ramb0t/Apollo-Voltmeter/README.md

Apollo-Voltmeter
================

Voltmeter Code for Design Two Module
