ramb0t/Apollo-Voltmeter/Eagle Project/Apollo Voltmeter/Main Board Rev1.0.bmp

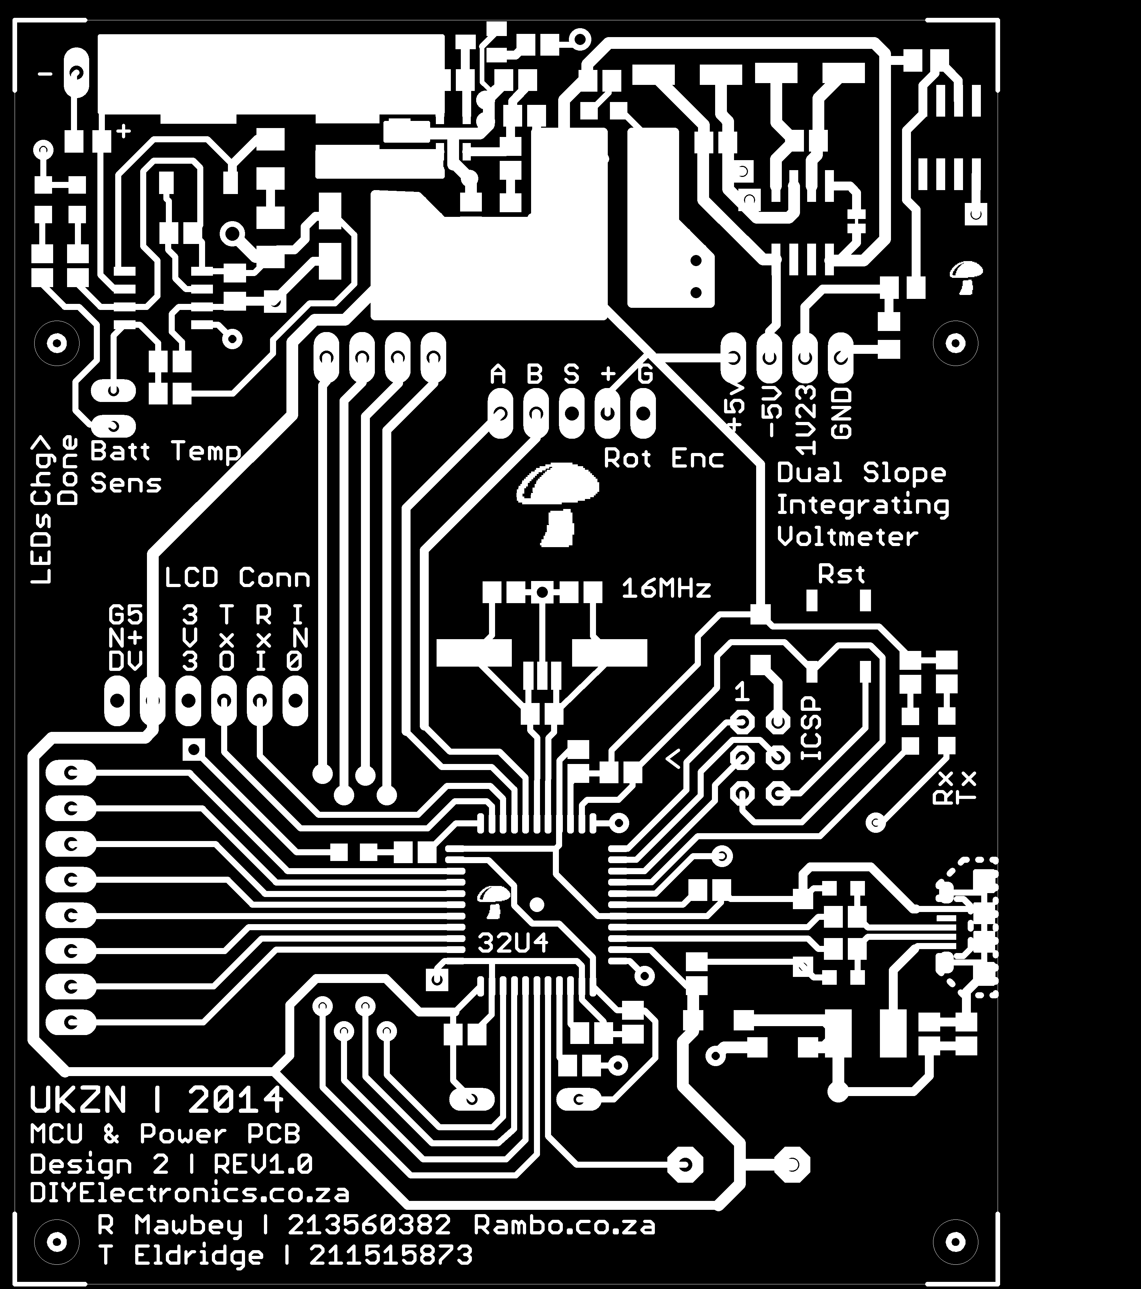
Eagle Project/Apollo Voltmeter/Main Board Rev1.0.bmp
