ramb0t/Apollo-Voltmeter/Eagle Project/Apollo Voltmeter/Panel Rev1.0.pdf

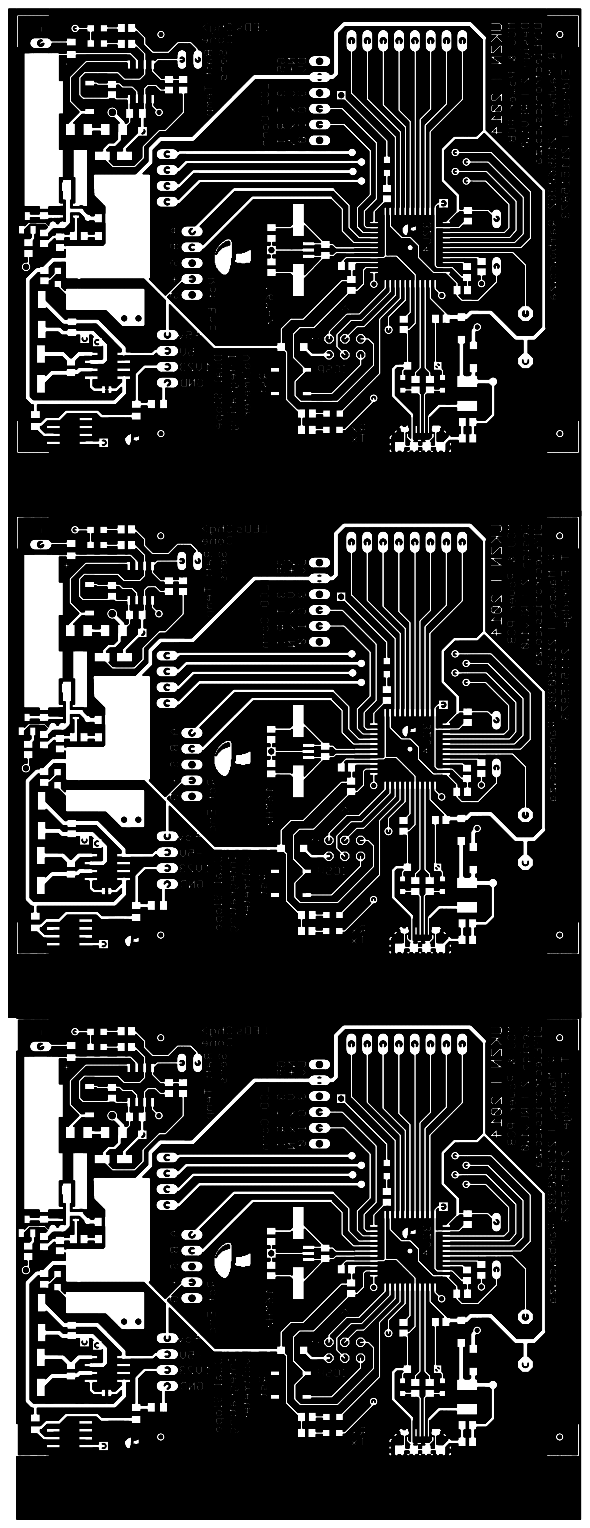
[picture p2: page 1]
