ramb0t/Apollo-Voltmeter/Eagle Project/Apollo Voltmeter/Vboost.brd

## EAGLE design Eagle Project/Apollo Voltmeter/Vboost.brd (2015-03-23)

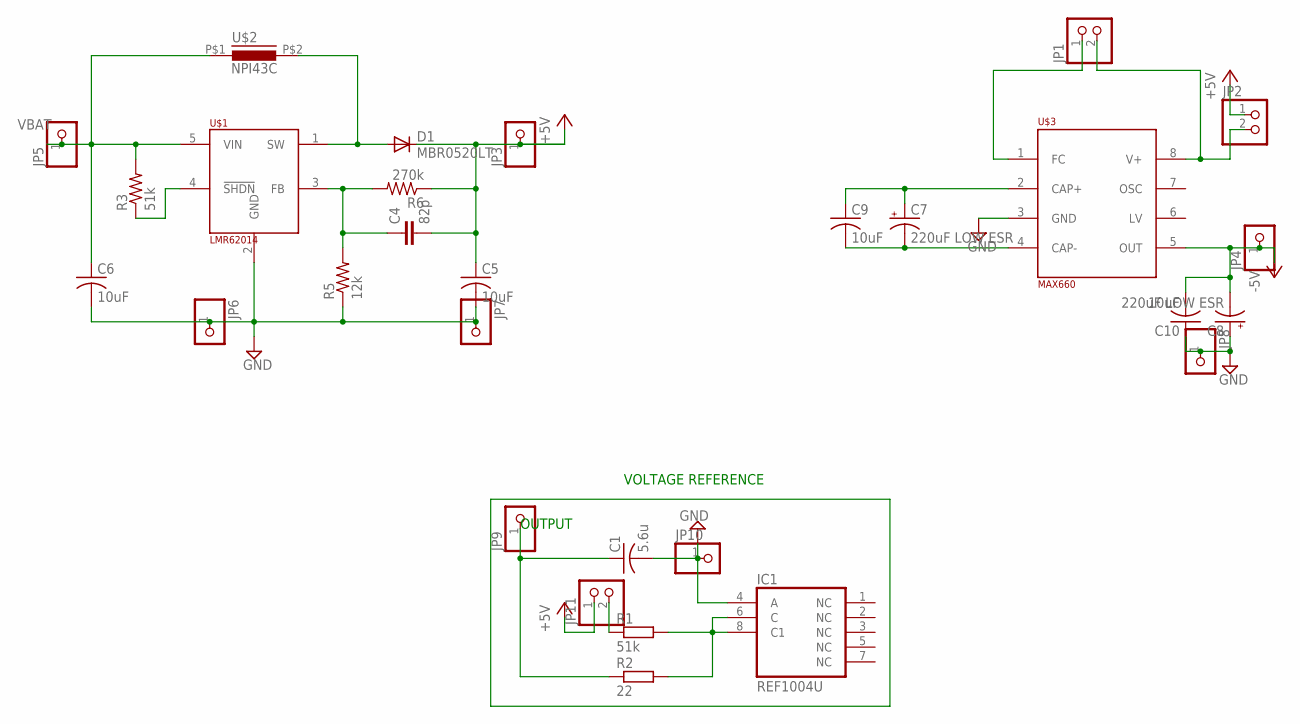
[picture p3: schematic Vboost.sch]

Parts:
C1: 5.6u; C0805K
C4: 82p; C0805
C5, C6, C9, C10: 10uF; C0805
C7, C8: 220uF LOW ESR; PANASONIC_D
D1: MBR0520LT; SOD123
IC1: REF1004U; SO08
JP1, JP2, JP11: PINHD-1X2; 1X02
JP3, JP4, JP5, JP6, JP7, JP8, JP9, JP10: PINHD-1X1; 1X01
R1: 51k; M0805
R2: 22; M0805
R3: 51k; R0805
R5: 12k; R0805
R6: 270k; R0805
U$1: LMR62014; SOT23-5
U$2: NPI43C
U$3: MAX660; SO08

Connections:
+5V: C4.2, C5.1, D1.C, JP2.1, JP3.1, JP11.1, R6.1
-5V: C8.-, C10.2, JP4.1, U$3.5 (OUT)
GND: C1.2, C5.2, C6.2, C8.+, C10.1, IC1.4 (A), JP6.1, JP7.1, JP8.1, JP10.1, R5.1, U$1.2 (GND), U$3.3 (GND)
unnamed: JP1.2, JP2.2, U$3.8 (V+)
unnamed: IC1.6 (C), IC1.8 (C1), R1.2, R2.2
unnamed: C1.1, JP9.1, R2.1
unnamed: C7.+, C9.1, U$3.2 (CAP+)
unnamed: JP11.2, R1.1
unnamed: R3.1, U$1.4 (!SHDN)
unnamed: C7.-, C9.2, U$3.4 (CAP-)
unnamed: C4.1, R5.2, R6.2, U$1.3 (FB)
unnamed: JP1.1, U$3.1 (FC)
SW: D1.A, U$1.1 (SW), U$2.P$2 (2)
VBAT: C6.1, JP5.1, R3.2, U$1.5 (VIN), U$2.P$1 (1)

Notes on the sheet:
OUTPUT
VOLTAGE REFERENCE

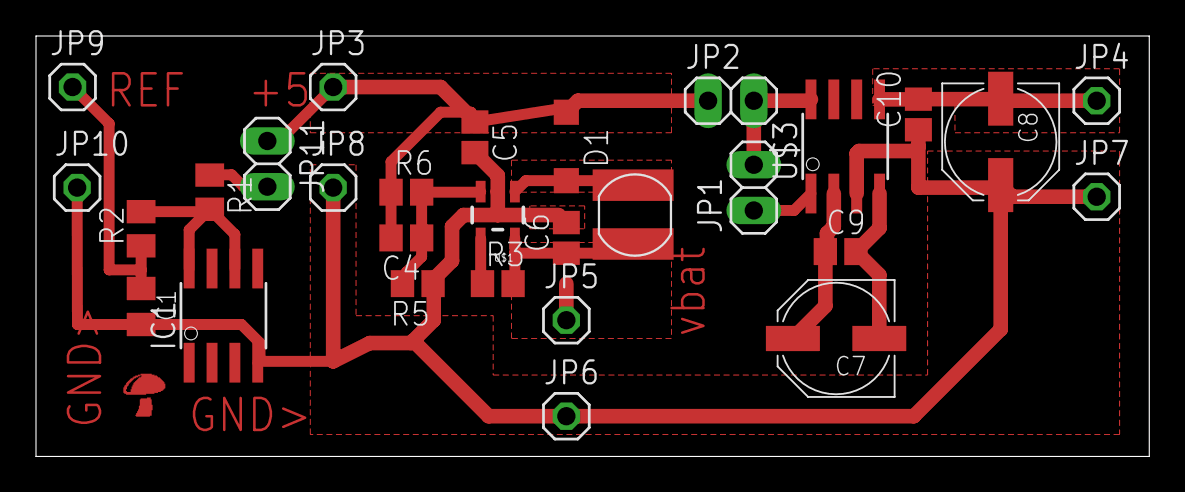
[picture p4: board Vboost.brd from above]

Board: 2 copper layers, 61.8 x 23.4 mm, 29 parts (0 on the bottom side), 14 nets.
