ramb0t/Apollo-Voltmeter/Eagle Project/Apollo Voltmeter/MCU Design exp.brd

## EAGLE design Eagle Project/Apollo Voltmeter/MCU Design exp.brd (2015-03-23)

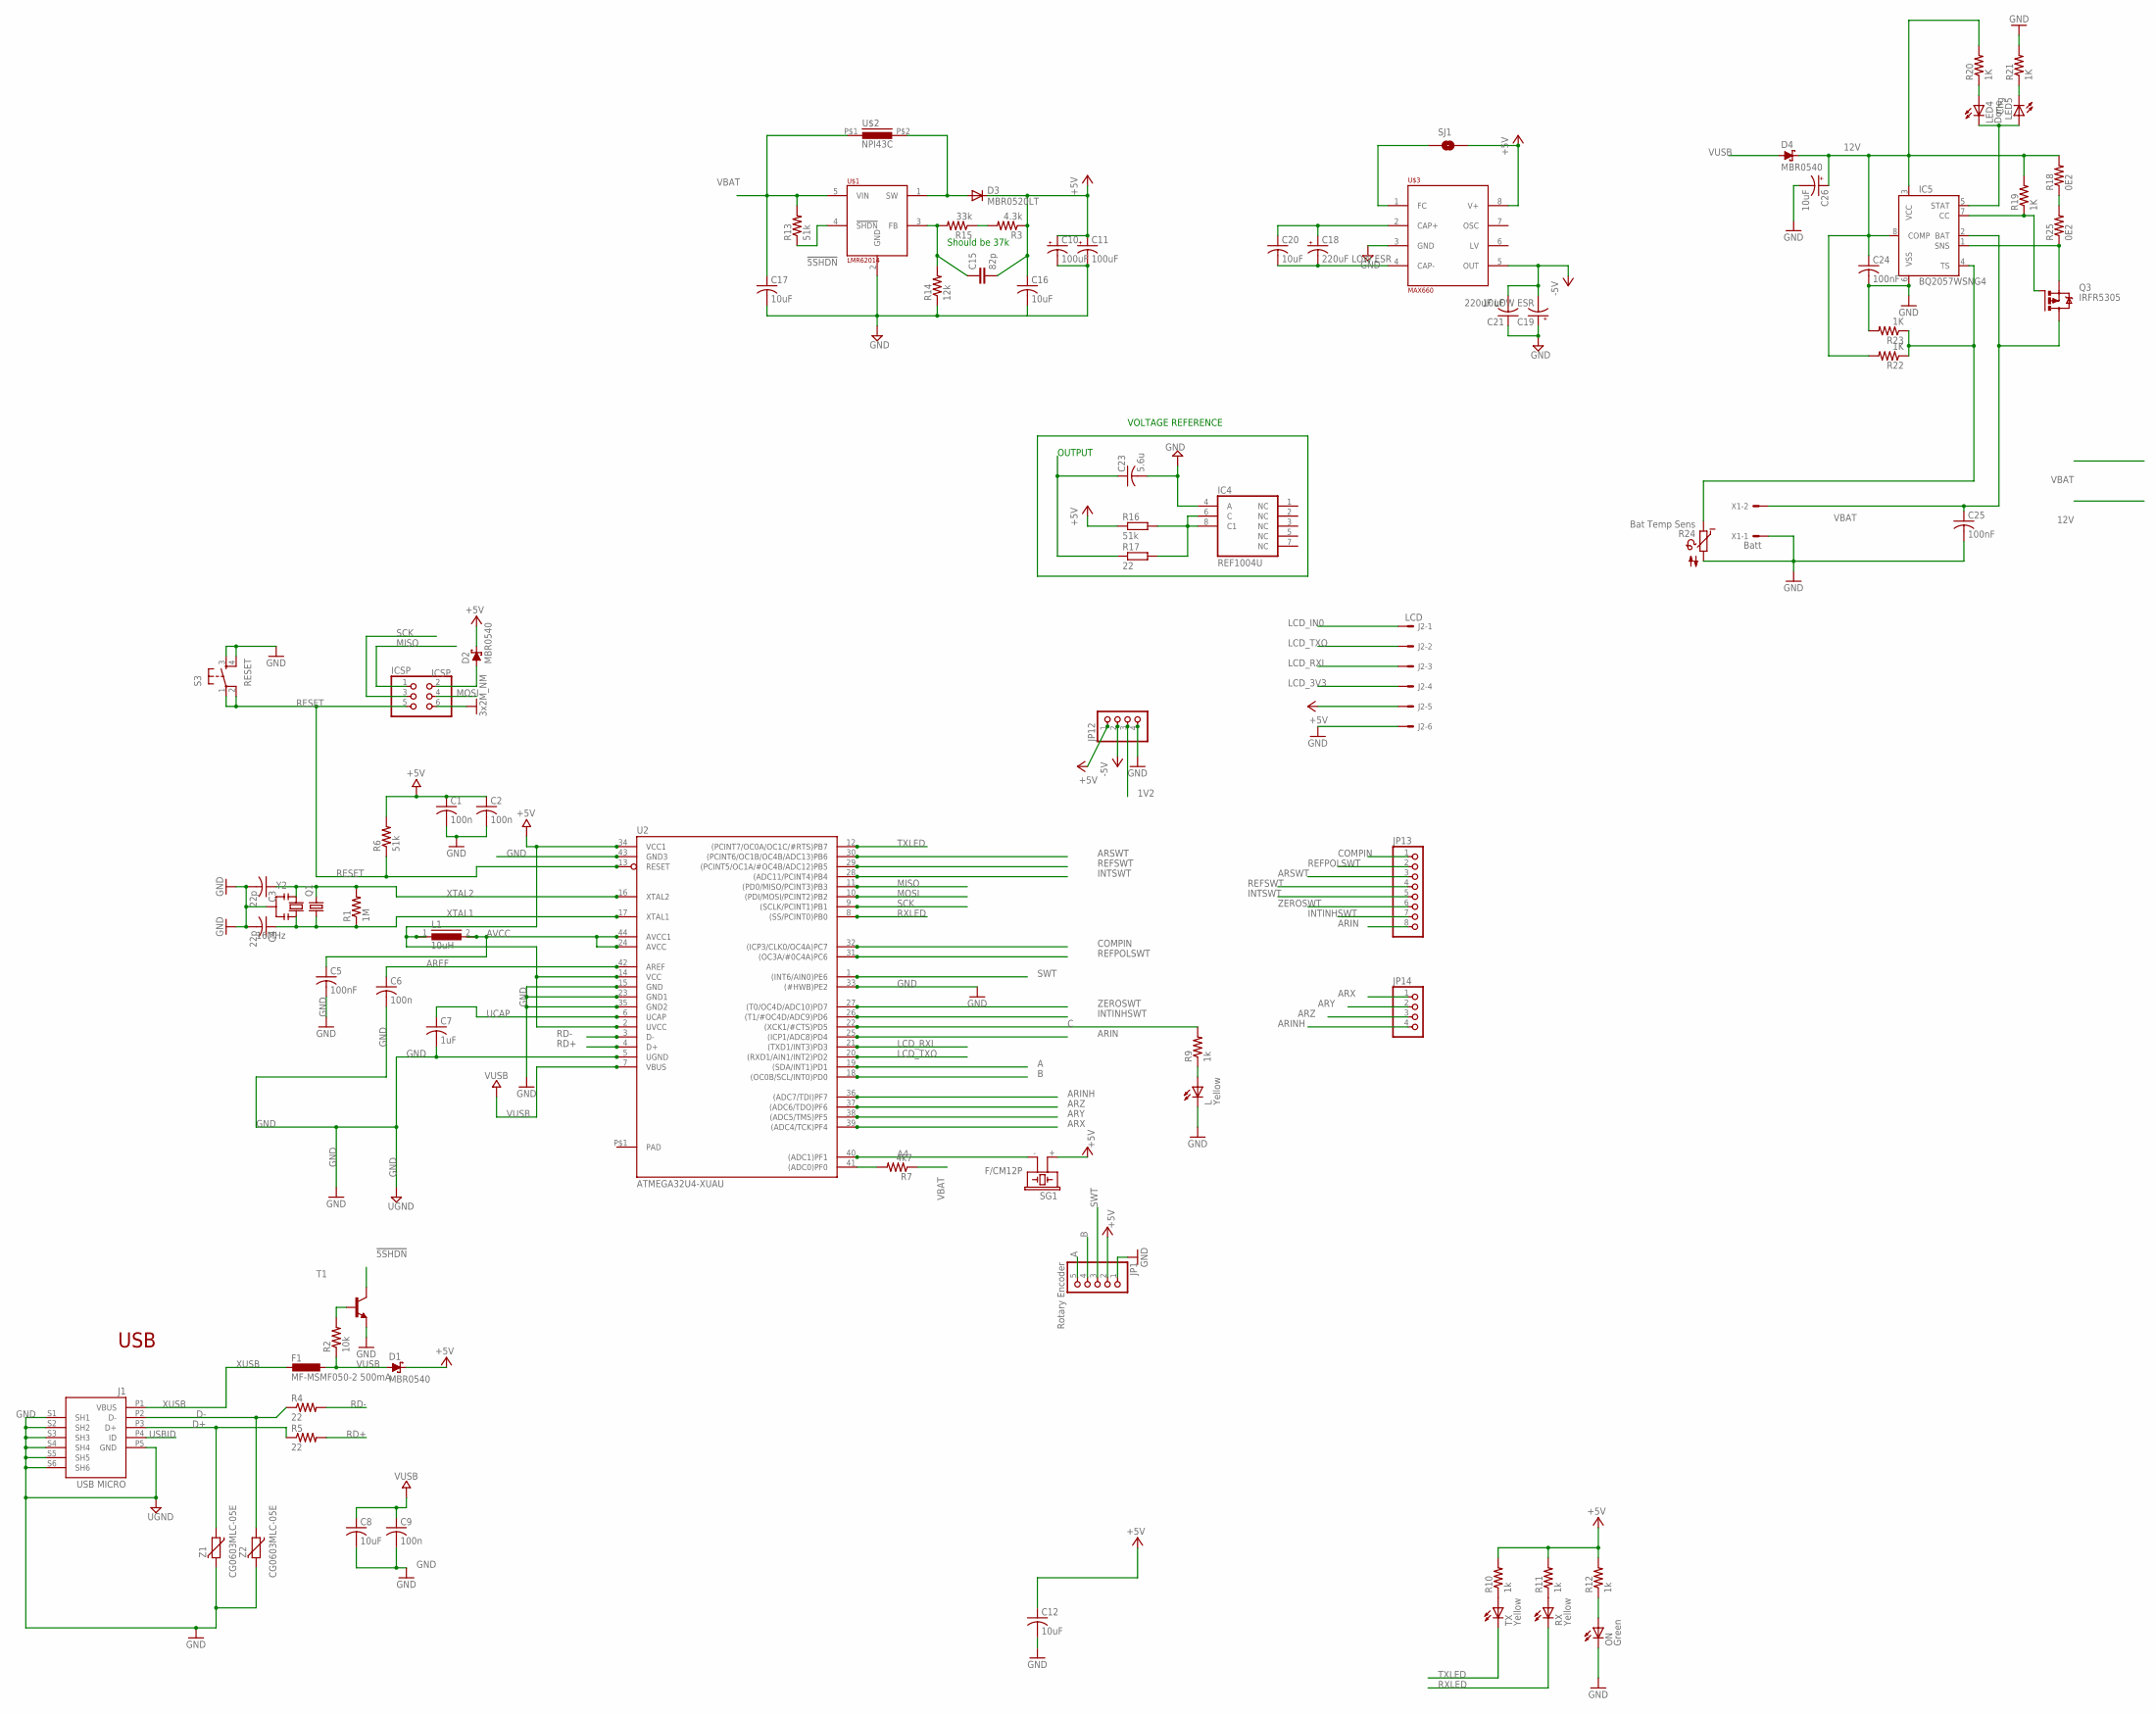
[picture p5: schematic MCU Design exp.sch]

Parts:
C1, C2, C6, C9: 100n; C0805
C3, C4: 22p; C0805
C5: 100nF; C0805
C7: 1uF; C0805
C8, C12, C16, C17, C20, C21: 10uF; C0805
C10, C11: 100uF; PANASONIC_D
C15: 82p; C0805
C18, C19: 220uF LOW ESR; PANASONIC_D
C23: 5.6u; C0805K
C24, C25: 100nF; C0805K
C26: 10uF; 153CLV-0405
D1, D2, D4: MBR0540; SOD123@2
D3: MBR0520LT; SOD123
F1: MF-MSMF050-2 500mA; L1812
IC4: REF1004U; SO08
IC5: BQ2057WSNG4; D_R-PDSO-G8
ICSP: ICSP; 2X03
J1: USB MICRO; CON2_USB_MICRO_B_AT
J2: LCD; 7395-06
JP1: Rotary Encoder; 1X05
JP12, JP14: PINHD-1X4; 1X04
JP13: PINHD-1X8; 1X08
L: Yellow; CHIPLED_0805
L1: 10uH; MMICC7
LED4: Done; CHIPLED_0805
LED5: Chg; CHIPLED_0805
ON: Green; CHIPLED_0805
Q1: CRYSTALHC49UP; HC49UP
Q3: IRFR5305; D-PAK_TO252AA
R1: 1M; R0805
R2: 10k; R0805
R3: 4.3k; R0805
R4, R5: 22; R0805
R6, R13: 51k; R0805
R7: 4k7; R0805
R9, R10, R11, R12: 1k; R0805
R14: 12k; R0805
R15: 33k; R0805
R16: 51k; M0805
R17: 22; M0805
R18, R25: 0E2; M1206
R19, R20, R21, R22, R23: 1K; R0805
R24: Bat Temp Sens; P640
RX: Yellow; CHIPLED_0805
S3: RESET; TACTILE_SWITCH_SMD
SG1: F/CM12P
SJ1: SOLDERJUMPERTRACE; SJ_2S-TRACE
T1: MMBT2222ALT1-NPN-SOT23-BEC; SOT23-BEC
TX: Yellow; CHIPLED_0805
U2: ATMEGA32U4-XUAU; TQFP44-PAD
U$1: LMR62014; SOT23-5
U$2: NPI43C
U$3: MAX660; SO08
X1: Batt; 22-23-2021
Y2: 16MHz; RESONATOR
Z1, Z2: CG0603MLC-05E; CT/CN0603

Connections:
1V2: C23.1, JP12.3, R17.1
12V: C24.1, C26.+, D4.C, IC5.3 (VCC), IC5.8 (COMP), R18.2, R19.2, R20.2, R22.2
!5SHDN: R13.1, T1.C, U$1.4 (!SHDN)
+5V: C1.1, C2.1, C10.+, C11.+, C12.1, C15.2, C16.1, D1.C, D2.C, D3.C, J2.5, JP1.2, JP12.1, L1.1, R3.1, R6.2, R10.2, R11.2, R12.2, R16.1, SG1.+ (1), SJ1.2, U2.2 (UVCC), U2.14 (VCC), U2.34 (VCC1), U$3.8 (V+)
-5V: C19.-, C21.2, JP12.2, U$3.5 (OUT)
A: JP1.5, U2.19 ((SDA/INT1)PD1)
A4: SG1.- (2), U2.40 ((ADC1)PF1)
AREF: C6.1, U2.42 (AREF)
ARIN: JP13.8, U2.25 ((ICP1/ADC8)PD4)
ARINH: JP14.4, U2.36 ((ADC7/TDI)PF7)
ARSWT: JP13.3, U2.30 ((PCINT6/OC1B/OC4B/ADC13)PB6)
ARX: JP14.1, U2.39 ((ADC4/TCK)PF4)
ARY: JP14.2, U2.38 ((ADC5/TMS)PF5)
ARZ: JP14.3, U2.37 ((ADC6/TDO)PF6)
AVCC: C5.1, L1.2, U2.24 (AVCC), U2.44 (AVCC1)
B: JP1.4, U2.18 ((OC0B/SCL/INT0)PD0)
C: R9.2, U2.22 ((XCK1/#CTS)PD5)
COMPIN: JP13.1, U2.32 ((ICP3/CLK0/OC4A)PC7)
D+: J1.P3 (D+), R5.1, Z1.1
D-: J1.P2 (D-), R4.1, Z2.1
GND: C1.2, C2.2, C3.2, C4.2, C5.2, C6.2, C7.2, C8.2, C9.2, C10.-, C11.-, C12.2, C16.2, C17.2, C19.+, C21.1, C23.2, C24.2, C25.2, C26.-, IC4.4 (A), IC5.6 (VSS), ICSP.6, J1.P5 (GND), J1.S1 (SH1), J1.S2 (SH2), J1.S3 (SH3), J1.S4 (SH4), J1.S5 (SH5), J1.S6 (SH6), J2.6, JP1.1, JP12.4, L.C, ON.C, R14.1, R21.2, R23.2, R24.2, S3.3, S3.4, T1.E, U2.5 (UGND), U2.15 (GND), U2.23 (GND1), U2.33 ((#HWB)PE2), U2.35 (GND2), U2.43 (GND3), U$1.2 (GND), U$3.3 (GND), X1.1, Y2.2, Z1.2, Z2.2
INTINHSWT: JP13.7, U2.26 ((T1/#OC4D/ADC9)PD6)
INTSWT: JP13.5, U2.28 ((ADC11/PCINT4)PB4)
LCD_3V3: J2.4
LCD_IN0: J2.1
LCD_RXI: J2.3, U2.21 ((TXD1/INT3)PD3)
LCD_TXO: J2.2, U2.20 ((RXD1/AIN1/INT2)PD2)
MISO: ICSP.1, U2.11 ((PD0/MISO/PCINT3)PB3)
MOSI: ICSP.4, U2.10 ((PDI/MOSI/PCINT2)PB2)
unnamed: R10.1, TX.A
unnamed: L.A, R9.1
unnamed: ON.A, R12.1
unnamed: R11.1, RX.A
unnamed: C18.+, C20.1, U$3.2 (CAP+)
unnamed: R7.2, U2.41 ((ADC0)PF0)
unnamed: IC4.6 (C), IC4.8 (C1), R16.2, R17.2
unnamed: R2.2, T1.B
unnamed: D2.A, ICSP.2
unnamed: R3.2, R15.1
unnamed: IC5.5 (STAT), LED4.C, LED5.A
unnamed: LED4.A, R20.1
unnamed: R18.1, R25.2
unnamed: C18.-, C20.2, U$3.4 (CAP-)
unnamed: C15.1, R14.2, R15.2, U$1.3 (FB)
unnamed: SJ1.1, U$3.1 (FC)
unnamed: IC5.1 (SNS), Q3.3 (S), R25.1
unnamed: IC5.7 (CC), Q3.1 (G), R19.1
unnamed: LED5.C, R21.1
unnamed: IC5.4 (TS), R22.1, R23.1, R24.1
PAD: U2.P$1 (PAD)
RD+: R5.2, U2.4 (D+)
RD-: R4.2, U2.3 (D-)
REFPOLSWT: JP13.2, U2.31 ((OC3A/#0C4A)PC6)
REFSWT: JP13.4, U2.29 ((PCINT5/OC1A/#OC4B/ADC12)PB5)
RESET: ICSP.5, R6.1, S3.1, S3.2, U2.13 (RESET)
RXLED: RX.C, U2.8 ((SS/PCINT0)PB0)
SCK: ICSP.3, U2.9 ((SCLK/PCINT1)PB1)
SW: D3.A, U$1.1 (SW), U$2.P$2 (2)
SWT: JP1.3, U2.1 ((INT6/AIN0)PE6)
TXLED: TX.C, U2.12 ((PCINT7/OC0A/OC1C/#RTS)PB7)
UCAP: C7.1, U2.6 (UCAP)
USBID: J1.P4 (ID)
VBAT: C17.1, C25.1, IC5.2 (BAT), Q3.4 (D), R7.1, R13.2, U$1.5 (VIN), U$2.P$1 (1), X1.2
VUSB: C8.1, C9.1, D1.A, D4.A, F1.1, R2.1, U2.7 (VBUS)
XTAL1: C4.1, Q1.1, R1.1, U2.17 (XTAL1), Y2.3
XTAL2: C3.1, Q1.2, R1.2, U2.16 (XTAL2), Y2.1
XUSB: F1.2, J1.P1 (VBUS)
ZEROSWT: JP13.6, U2.27 ((T0/OC4D/ADC10)PD7)

Notes on the sheet:
USB
OUTPUT
VOLTAGE REFERENCE
Should be 37k

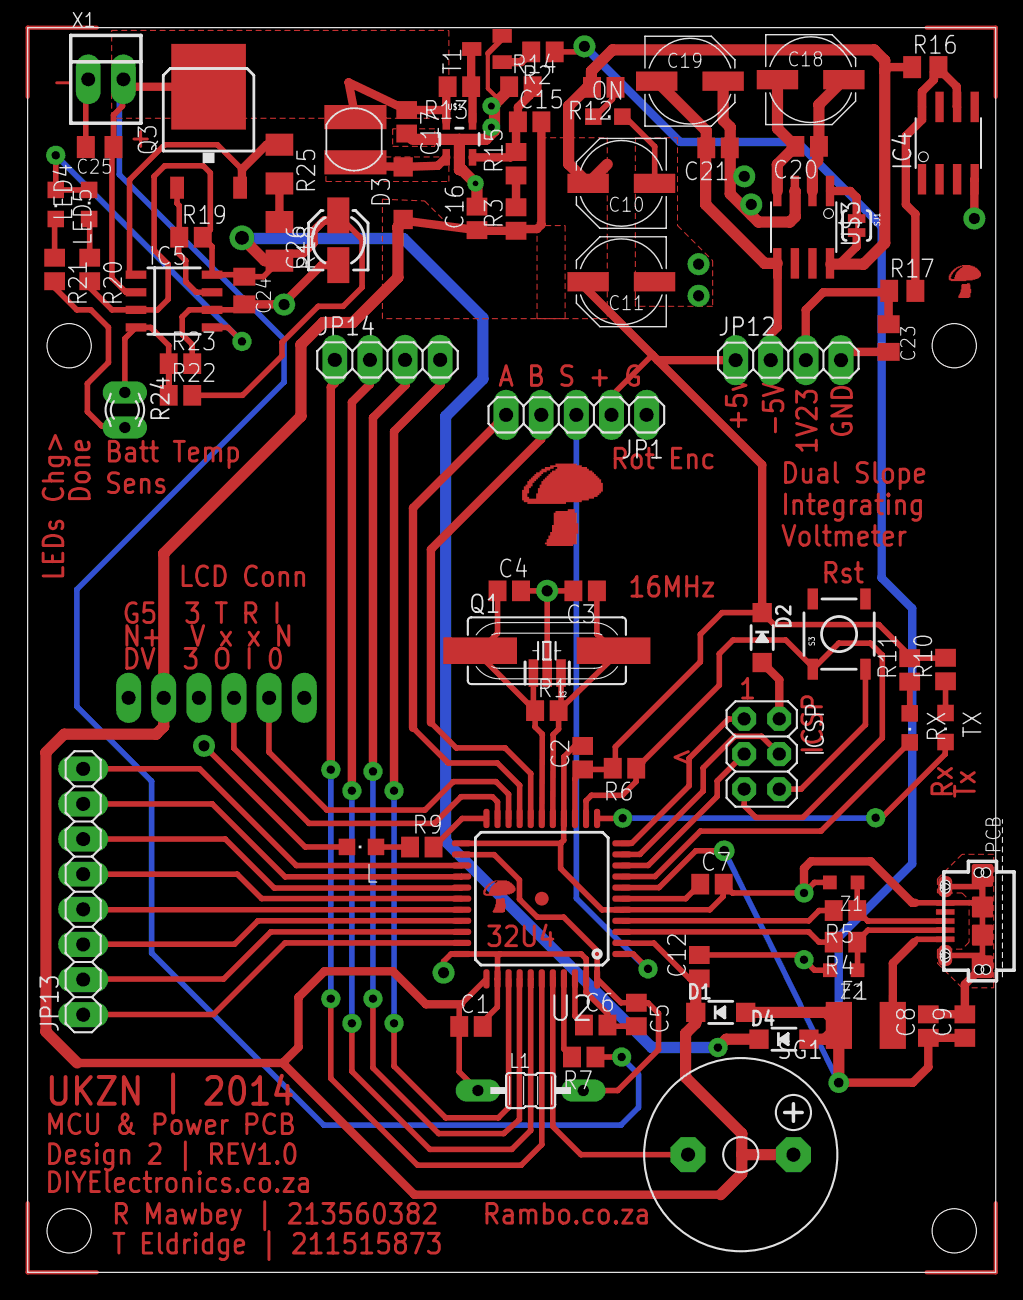
[picture p6: board MCU Design exp.brd from above]

Board: 2 copper layers, 70.0 x 90.0 mm, 82 parts (1 on the bottom side), 64 nets.
