ramb0t/Apollo-Voltmeter/(commit log)

2014-08-31 Testing out alt lcd driver
2014-09-29 Working code on final Apollo board without AFE
2014-09-30 Modified bootloader to timeout just like arduino!
2015-03-23 Added eagle files
    [MCU Design exp neat.brd, MCU Design exp neat.sch, MCU Design exp.brd, MCU Design exp.sch, MCU Design.brd, MCU Design.sch, Vboost.brd, Vboost.sch]
